MarcusQuek/Marcus-s-ESP32-Dev-Board/SM02B-SRSS-TB(LF)(SN).step

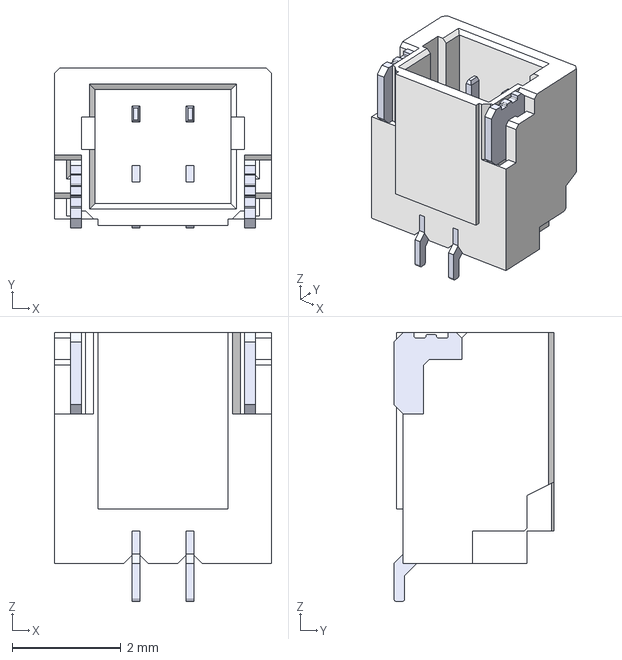
[picture p1: CAD file, 2025-12-24]
SM02B-SRSS-TB(LF)(SN).step
4.00 x 2.95 x 4.95 mm
