MarcusQuek/Marcus-s-ESP32-Dev-Board/MMC5983MA_MEM.step

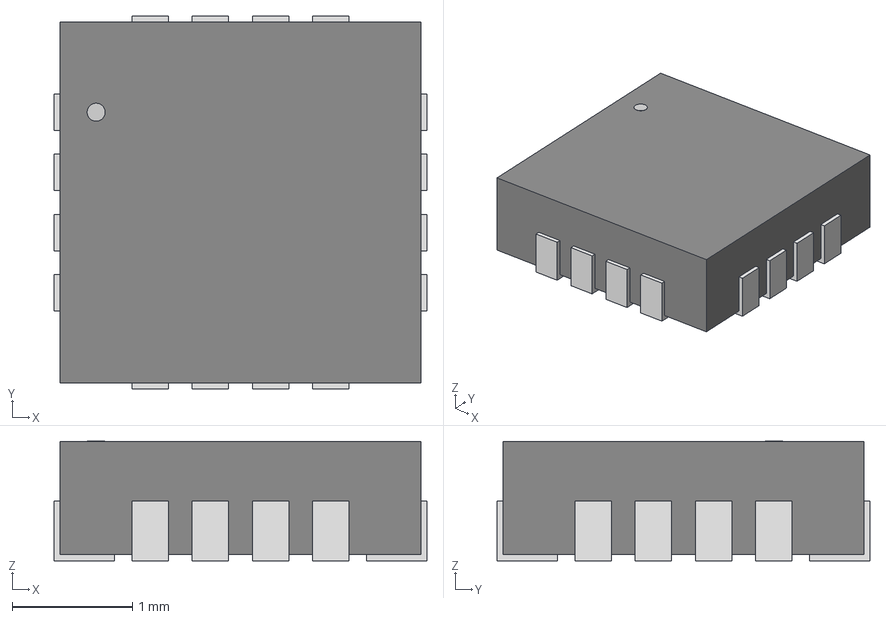
[picture p2: CAD file, 2025-12-24]
MMC5983MA_MEM.step
3.10 x 3.10 x 0.993 mm
