MarcusQuek/Marcus-s-ESP32-Dev-Board/ESP32-S3-WROOM-1U-N16R8.STEP

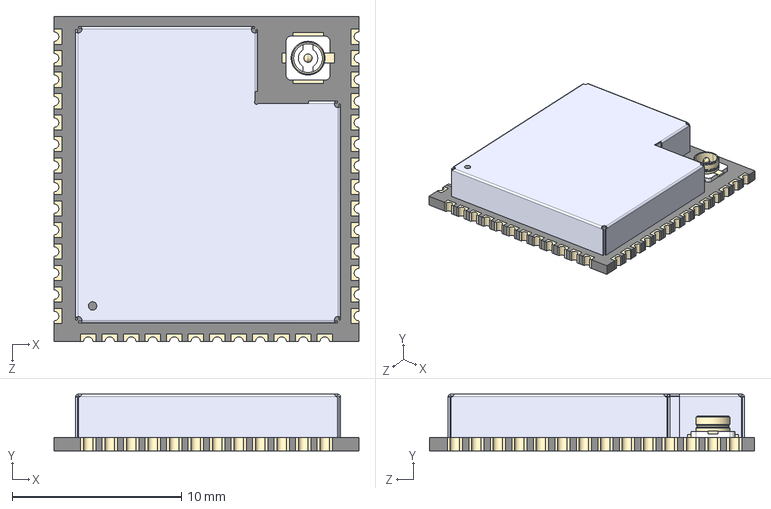
[picture p3: CAD file, 2025-12-22]
ESP32-S3-WROOM-1U-N16R8.STEP
18.0 x 3.35 x 19.2 mm
