MarcusQuek/Marcus-s-ESP32-Dev-Board/USB3076-30-A.STEP

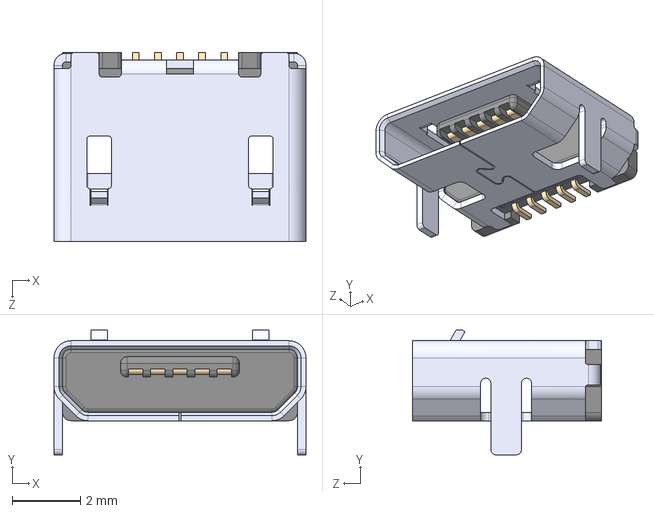
[picture p4: CAD file, 2025-12-22]
USB3076-30-A.STEP
7.40 x 3.66 x 5.55 mm
