MarcusQuek/Marcus-s-ESP32-Dev-Board/TPS63020DSJR.step

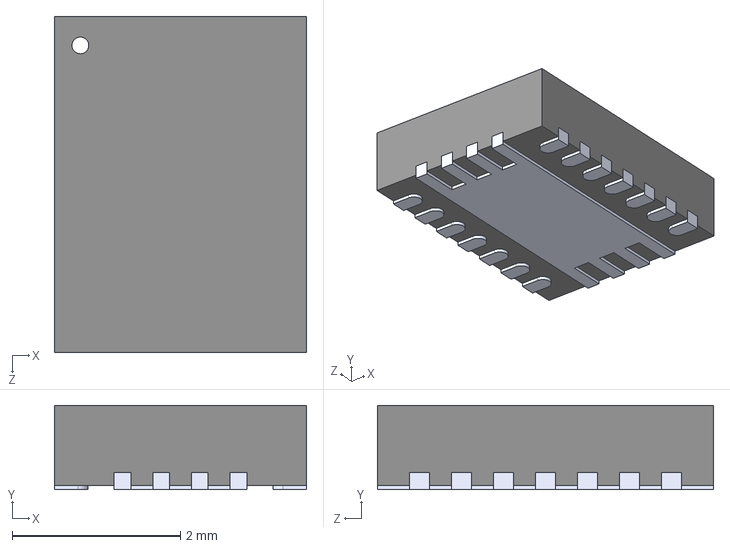
[picture p5: CAD file, 2025-12-24]
TPS63020DSJR.step
3.00 x 1.00 x 4.00 mm
