MarcusQuek/Marcus-s-ESP32-Dev-Board/MAX17048G_T10.step

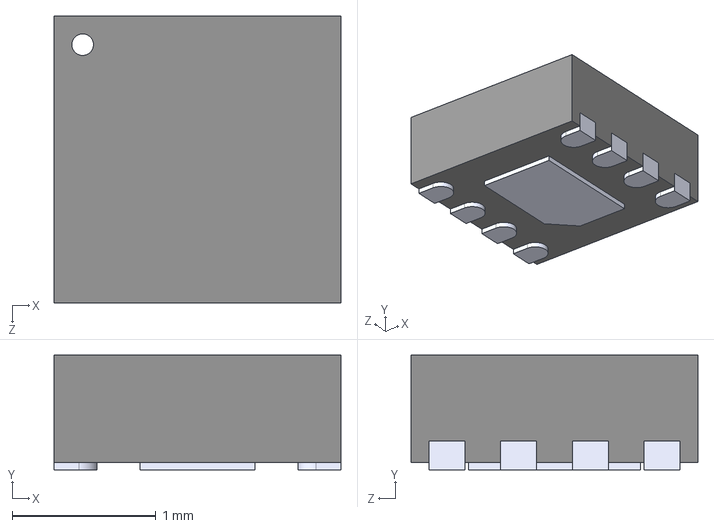
[picture p6: CAD file, 2025-12-24]
MAX17048G_T10.step
2.00 x 0.8 x 2.00 mm
