MarcusQuek/Marcus-s-ESP32-Dev-Board/0473092651.stp

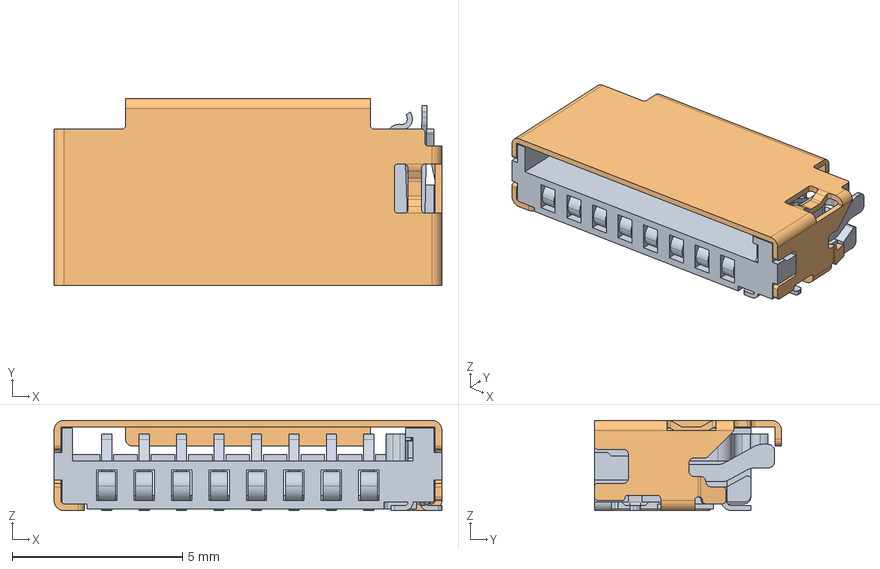
[picture p7: CAD file, 2025-12-24]
0473092651.stp
11.4 x 5.50 x 2.65 mm
