MarcusQuek/Marcus-s-ESP32-Dev-Board/Marcus's ESP32 Dev Board.kicad_pcb

## KiCad design Marcus's ESP32 Dev Board.kicad_pcb (2025-12-24)

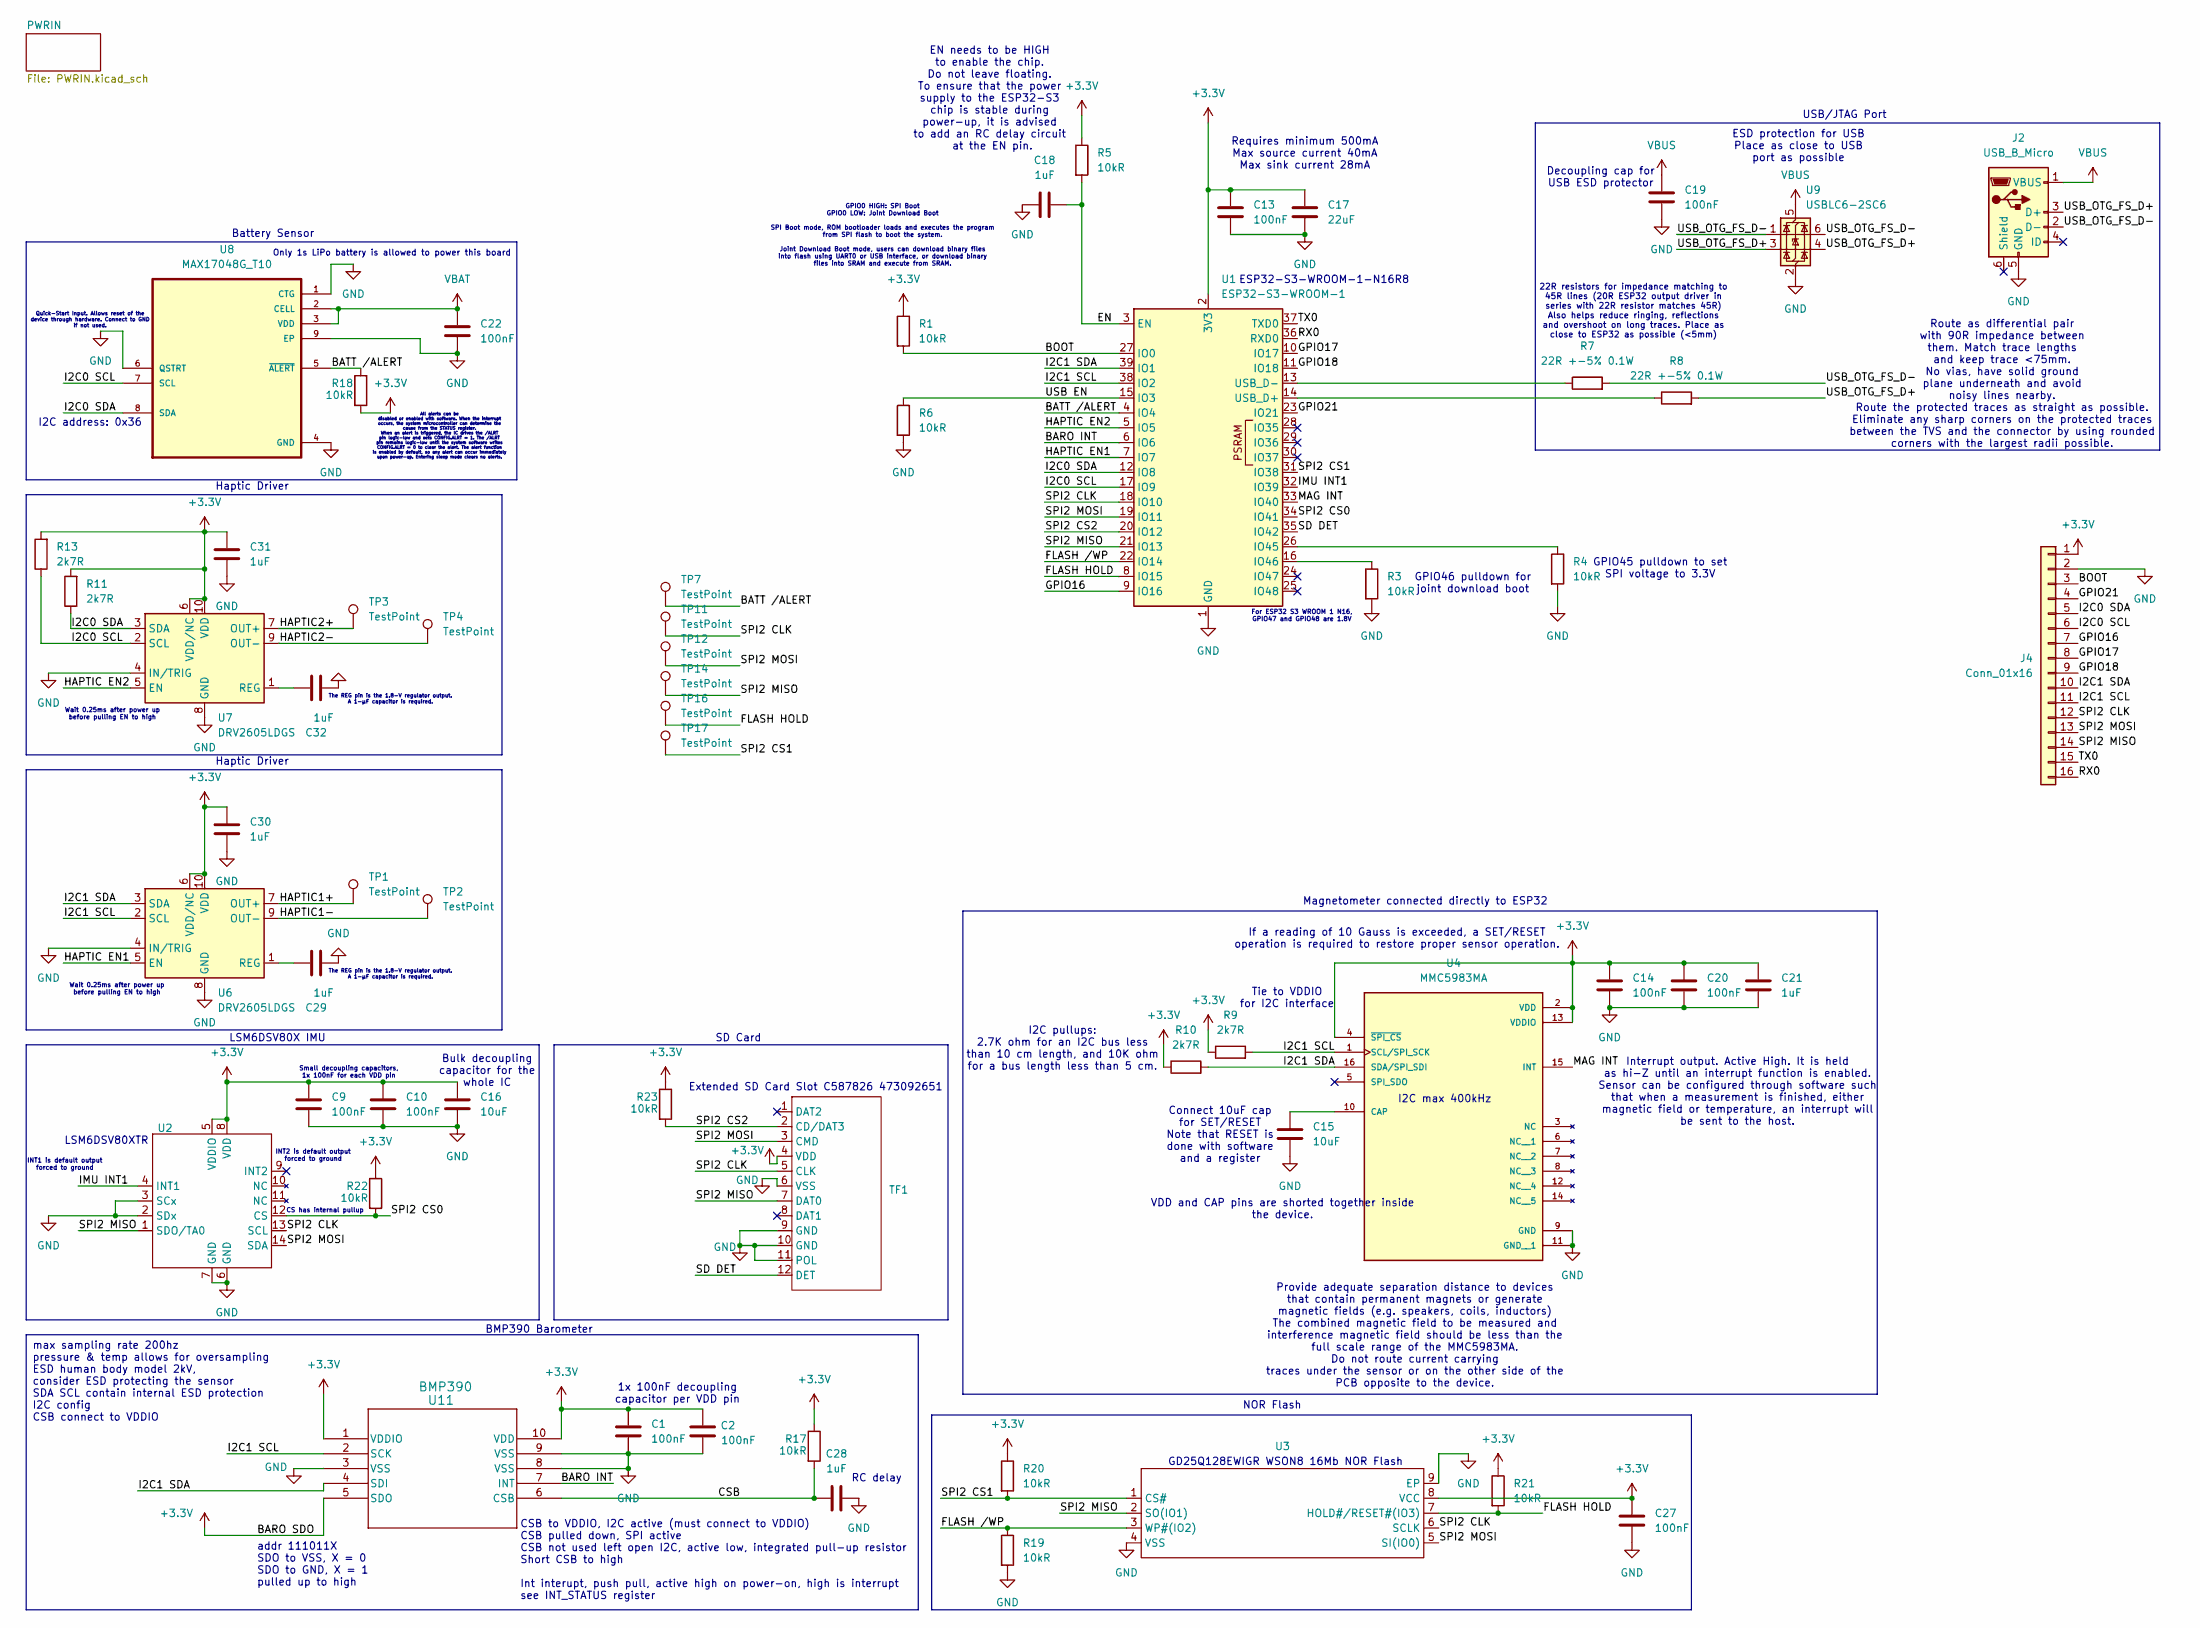
[picture p8: schematic Marcus's ESP32 Dev Board.kicad_sch]

Parts:
C1, C2, C9, C10, C13, C14, C19, C20, C22, C27: 100nF; C_0402_1005Metric
C15, C16: 10uF; C_0603_1608Metric
C17: 22uF; C_0805_2012Metric
C18, C21, C28, C29, C30, C31, C32: 1uF; C_0402_1005Metric
J2: USB_B_Micro; USB_Micro-B_GCT_USB3076-30-A
J4: Conn_01x16; PinHeader_1x16_P1.27mm_Vertical
R1, R3, R4, R5, R6, R17, R18, R19, R20, R21, R22, R23: 10kR; R_0201_0603Metric
R7, R8: 22R +-5% 0.1W; R_0201_0603Metric
R9, R10, R11, R13: 2k7R; C_0402_1005Metric
TF1: Extended SD Card Slot C587826 473092651; Manufacturer Part 473092651; LCSC Part Name 473092651
TP1, TP2, TP3, TP4: TestPoint; TestPoint_Pad_2.0x2.0mm
TP7, TP11, TP12, TP14, TP16, TP17: TestPoint; TestPoint_Pad_D1.0mm
U1: ESP32-S3-WROOM-1; ESP32-S3-WROOM-1U
U2: LGA-14_3x2.5mm_P0.5mm_LayoutBorder3x4y
U3: WSON-8-1EP_6x5mm_P1.27mm_EP3.4x4.3mm; Manufacturer Part GD25Q128EWIGR; LCSC Part Name 双路和四路串行闪存
U4: MMC5983MA; PARTREV A
U6, U7: DRV2605LDGS; VSSOP-10_3x3mm_P0.5mm
U8: MAX17048G_T10; MAX17048G+T10
U9: USBLC6-2SC6; SOT-23-6
U11: BMP390

Connections:
+3.3V: C1.1, C2.2, C9.1, C10.1, C13.1, C14.1, C16.1, C17.1, C20.1, C21.1, C27.1, C30.2, C31.2, J4.1, R1.1, R5.1, R9.1, R10.1, R11.2, R13.2, R17.1, R18.2, R20.1, R21.1, R22.1, R23.1, TF1.4 (VDD), U1.2 (3V3), U2.5 (VDDIO), U2.8 (VDD), U3.8 (VCC), U4.2 (VDD), U4.4 (~SPI_CS), U4.13 (VDDIO), U6.6 (VDD/NC), U6.10 (VDD), U7.6 (VDD/NC), U7.10 (VDD), U11.1 (VDDIO), U11.5 (SDO), U11.10 (VDD); also elsewhere on the board
/BARO INT: U1.6 (IO6), U11.7 (INT)
/BATT /ALERT: R18.1, TP7.1, U1.4 (IO4), U8.5 (~ALERT)
/BOOT: J4.3, R1.2, U1.27 (IO0)
/CSB: C28.1, R17.2, U11.6 (CSB)
/EN: C18.2, R5.2, U1.3 (EN)
/FLASH HOLD: R21.2, TP16.1, U1.8 (IO15), U3.7 (HOLD#/RESET#(IO3))
/FLASH /WP: R19.1, U1.22 (IO14), U3.3 (WP#(IO2))
/GPIO16: J4.7, U1.9 (IO16)
/GPIO17: J4.8, U1.10 (IO17)
/GPIO18: J4.9, U1.11 (IO18)
/GPIO21: J4.4, U1.23 (IO21)
/HAPTIC1+: TP1.1, U6.7 (OUT+)
/HAPTIC1-: TP2.1, U6.9 (OUT-)
/HAPTIC2+: TP3.1, U7.7 (OUT+)
/HAPTIC2-: TP4.1, U7.9 (OUT-)
/HAPTIC EN1: U1.7 (IO7), U6.5 (EN)
/HAPTIC EN2: U1.5 (IO5), U7.5 (EN)
/I2C0 SCL: J4.6, R13.1, U1.17 (IO9), U7.2 (SCL), U8.7 (SCL)
/I2C0 SDA: J4.5, R11.1, U1.12 (IO8), U7.3 (SDA), U8.8 (SDA)
/I2C1 SCL: J4.11, R9.2, U1.38 (IO2), U4.1 (SCL/SPI_SCK), U6.2 (SCL), U11.2 (SCK)
/I2C1 SDA: J4.10, R10.2, U1.39 (IO1), U4.16 (SDA/SPI_SDI), U6.3 (SDA), U11.4 (SDI)
/IMU INT1: U1.32 (IO39), U2.4 (INT1)
/MAG INT: U1.33 (IO40), U4.15 (INT)
/RX0: J4.16, U1.36 (RXD0)
/SD DET: TF1.12 (DET), U1.35 (IO42)
/SPI2 CLK: J4.12, TF1.5 (CLK), TP11.1, U1.18 (IO10), U2.13 (SCL), U3.6 (SCLK)
/SPI2 CS0: R22.2, U1.34 (IO41), U2.12 (CS)
/SPI2 CS1: R20.2, TP17.1, U1.31 (IO38), U3.1 (CS#)
/SPI2 CS2: R23.2, TF1.2 (CD/DAT3), U1.20 (IO12)
/SPI2 MISO: J4.14, TF1.7 (DAT0), TP14.1, U1.21 (IO13), U2.1 (SDO/TA0), U3.2 (SO(IO1))
/SPI2 MOSI: J4.13, TF1.3 (CMD), TP12.1, U1.19 (IO11), U2.14 (SDA), U3.5 (SI(IO0))
/TX0: J4.15, U1.37 (TXD0)
/USB EN: R6.1, U1.15 (IO3)
/USB_OTG_FS_D+: J2.3 (D+), R8.2, U9.3 (I/O2), U9.4 (I/O2)
/USB_OTG_FS_D-: J2.2 (D-), R7.2, U9.1 (I/O1), U9.6 (I/O1)
GND: C1.2, C2.1, C9.2, C10.2, C13.2, C14.2, C15.2, C16.2, C17.2, C18.1, C19.2, C20.2, C21.2, C22.2, C27.2, C28.2, C29.1, C30.1, C31.1, C32.1, J2.5 (GND), J4.2, R3.2, R4.2, R6.2, R19.2, TF1.6 (VSS), TF1.9 (GND), TF1.10 (GND), TF1.11 (POL), U1.1 (GND), U1.40 (GND), U1.41 (GND), U2.2 (SDx), U2.3 (SCx), U2.6 (GND), U2.7 (GND), U3.4 (VSS), U3.9 (EP), U4.9 (GND), U4.11 (GND__1), U6.4 (IN/TRIG), U6.8 (GND), U7.4 (IN/TRIG), U7.8 (GND), U8.1 (CTG), U8.4 (GND), U8.6 (QSTRT), U8.9 (EP), U9.2 (GND), U11.3 (VSS), U11.8 (VSS), U11.9 (VSS); also elsewhere on the board
unnamed: R4.1, U1.26 (IO45)
unnamed: R3.1, U1.16 (IO46)
unnamed: R8.1, U1.14 (USB_D+)
unnamed: R7.1, U1.13 (USB_D-)
unnamed: C15.1, U4.10 (CAP)
unnamed: C29.2, U6.1 (REG)
unnamed: C32.2, U7.1 (REG)
VBAT: C22.1, U8.2 (CELL), U8.3 (VDD); also elsewhere on the board
VBUS: C19.1, J2.1 (VBUS), U9.5 (VBUS); also elsewhere on the board

Notes on the sheet:
LSM6DSV80XTR
INT2 is default output forced to ground
I2C address: 0x36
Connect 10uF cap for SET/RESET Note that RESET is done with software and a register
EN needs to be HIGH to enable the chip. Do not leave floating. To ensure that the power supply to the ESP32-S3 chip is stable during power-up, it is advised to add an RC delay circuit at the EN pin.
ESP32-S3-WROOM-1-N16R8
ESD protection for USB Place as close to USB port as possible
CS has internal pullup
GPIO46 pulldown for joint download boot
VDD and CAP pins are shorted together inside the device.
Battery Sensor
GPIO45 pulldown to set SPI voltage to 3.3V
Route as differential pair with 90R impedance between them. Match trace lengths and keep trace <75mm. No vias, have solid ground plane underneath and avoid noisy lines nearby. Route the protected traces as straight as possible. Eliminate any sharp corners on the protected traces between the TVS and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
Wait 0.25ms after power up before pulling EN to high
Small decoupling capacitors, 1x 100nF for each VDD pin
I2C max 400kHz
LSM6DSV80X IMU
RC delay
Extended SD Card Slot C587826 473092651
Bulk decoupling capacitor for the whole IC
Haptic Driver
addr 111011X SDO to VSS, X = 0 SDO to GND, X = 1 pulled up to high
max sampling rate 200hz pressure & temp allows for oversampling ESD human body model 2kV, consider ESD protecting the sensor SDA SCL contain internal ESD protection I2C config CSB connect to VDDIO
Only 1s LiPo battery is allowed to power this board
For ESP32 S3 WROOM 1 N16, GPIO47 and GPIO48 are 1.8V
Magnetometer connected directly to ESP32
I2C pullups: 2.7K ohm for an I2C bus less than 10 cm length, and 10K ohm for a bus length less than 5 cm.
Tie to VDDIO for I2C interface
The REG pin is the 1.8-V regulator output. A 1-µF capacitor is required.
Interrupt output. Active High. It is held as hi-Z until an interrupt function is enabled. Sensor can be configured through software such that when a measurement is finished, either magnetic field or temperature, an interrupt will be sent to the host.
Requires minimum 500mA Max source current 40mA Max sink current 28mA
INT1 is default output forced to ground
BMP390 Barometer
1x 100nF decoupling capacitor per VDD pin
Quick-Start Input. Allows reset of the device through hardware. Connect to GND if not used.
NOR Flash
USB/JTAG Port
All alerts can be disabled or enabled with software. When the interrupt occurs, the system microcontroller can determine the cause from the STATUS register. When an alert is triggered, the IC drives the /ALRT pin logic-low and sets CONFIG.ALRT = 1. The /ALRT pin remains logic-low until the system s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
CSB to VDDIO, I2C active (must connect to VDDIO) CSB pulled down, SPI active CSB not used left open I2C, active low, integrated pull-up resistor Short CSB to high Int interupt, push pull, active high on power-on, high is interrupt see INT_STATUS register
22R resistors for impedance matching to 45R lines (20R ESP32 output driver in series with 22R resistor matches 45R) Also helps reduce ringing, reflections and overshoot on long traces. Place as close to ESP32 as possible (<5mm)
GPIO0 HIGH: SPI Boot GPIO0 LOW: Joint Download Boot SPI Boot mode, ROM bootloader loads and executes the program from SPI flash to boot the system. Joint Download Boot mode, users can download binary files into flash using UART0 or USB interface, or download binary files into SRAM and execute from 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
GD25Q128EWIGR WSON8 16Mb NOR Flash
SD Card
Provide adequate separation distance to devices that contain permanent magnets or generate magnetic fields (e.g. speakers, coils, inductors) The combined magnetic field to be measured and interference magnetic field should be less than the full scale range of the MMC5983MA. Do not route current car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
Decoupling cap for USB ESD protector
If a reading of 10 Gauss is exceeded, a SET/RESET operation is required to restore proper sensor operation.

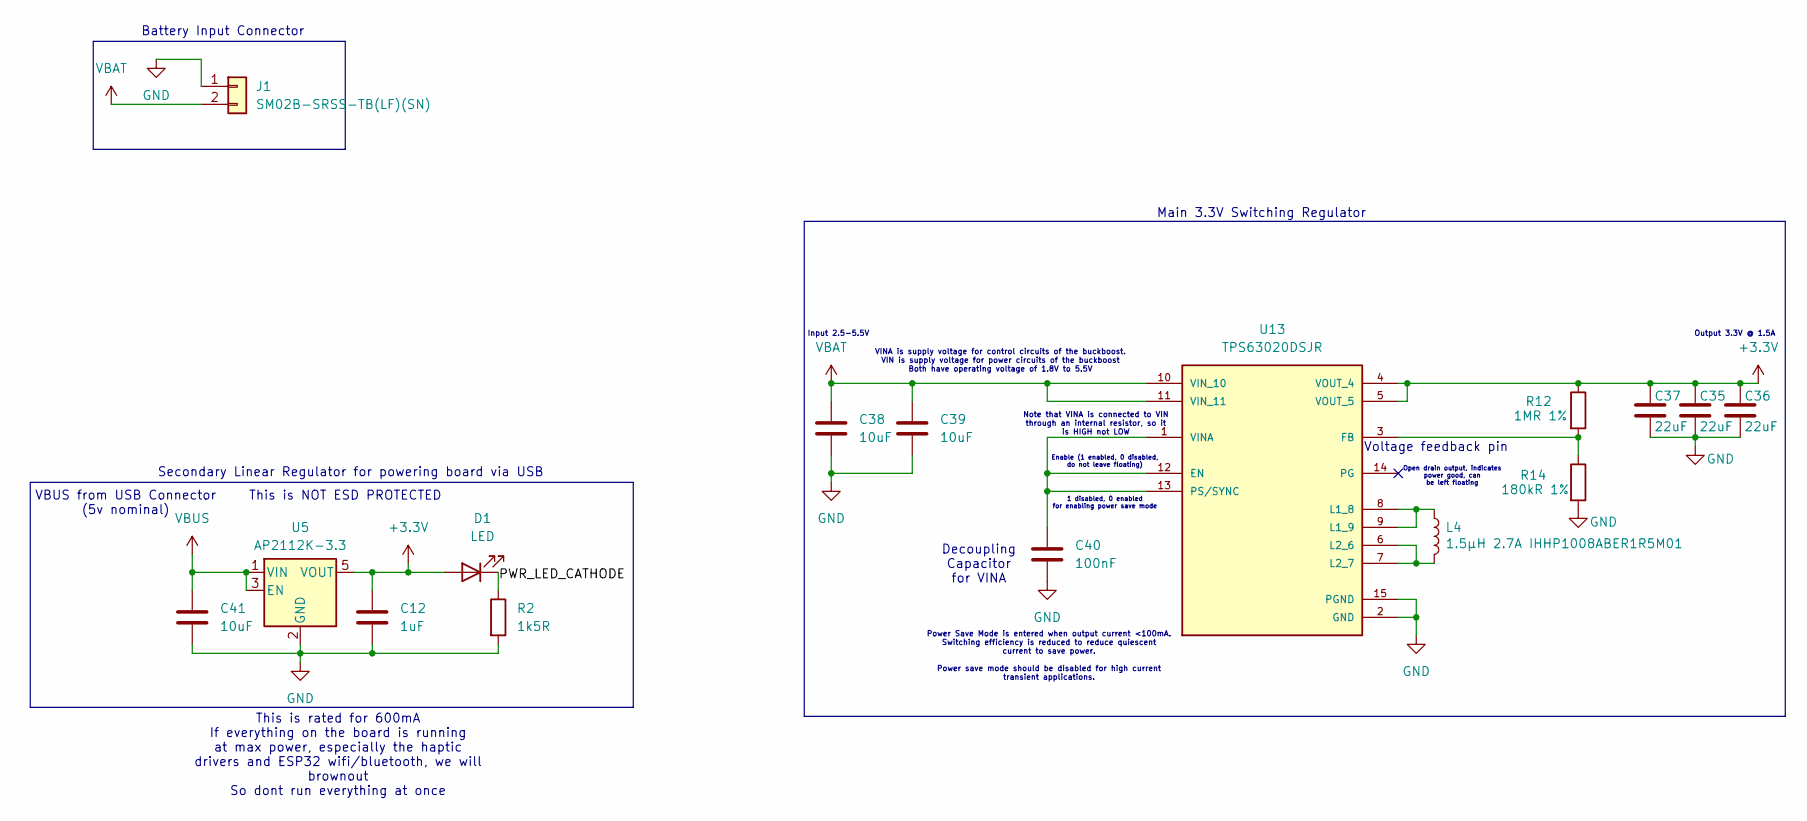
[picture p9: schematic PWRIN.kicad_sch]

Parts:
C12: 1uF; C_0402_1005Metric
C35, C36, C37: 22uF; C_0805_2012Metric
C38, C39, C41: 10uF; C_0603_1608Metric
C40: 100nF; C_0402_1005Metric
D1: LED; LED_0603_1608Metric
J1: SM02B-SRSS-TB(LF)(SN); JST_SH_SM02B-SRSS-TB_1x02-1MP_P1.00mm_Horizontal
L4: 1.5µH 2.7A IHHP1008ABER1R5M01; L_1008_2520Metric
R2: 1k5R; C_0402_1005Metric
R12: 1MR 1%; R_0201_0603Metric
R14: 180kR 1%; R_0201_0603Metric
U5: AP2112K-3.3; SOT-23-5
U13: TPS63020DSJR

Connections:
+3.3V: C12.1, C35.1, C36.1, C37.1, D1.2 (A), R12.1, U5.5 (VOUT), U13.4 (VOUT_4), U13.5 (VOUT_5); also elsewhere on the board
/PWRIN/PWR_LED_CATHODE: D1.1 (K), R2.1
GND: C12.2, C35.2, C36.2, C37.2, C38.2, C39.2, C40.2, C41.2, J1.1, R2.2, R14.2, U5.2 (GND), U13.2 (GND), U13.15 (PGND), U13.16, U13.18, U13.20, U13.22, U13.24, U13.26, U13.28, U13.30; also elsewhere on the board
unnamed: C40.1, U13.1 (VINA), U13.12 (EN), U13.13 (PS/SYNC)
unnamed: R12.2, R14.1, U13.3 (FB)
unnamed: L4.1, U13.8 (L1_8), U13.9 (L1_9)
unnamed: L4.2, U13.6 (L2_6), U13.7 (L2_7)
VBAT: C38.1, C39.1, J1.2, U13.10 (VIN_10), U13.11 (VIN_11); also elsewhere on the board
VBUS: C41.1, U5.1 (VIN), U5.3 (EN); also elsewhere on the board

Notes on the sheet:
Power Save Mode is entered when output current <100mA. Switching efficiency is reduced to reduce quiescent current to save power. Power save mode should be disabled for high current transient applications.
Note that VINA is connected to VIN through an internal resistor, so it is HIGH not LOW
This is NOT ESD PROTECTED
Voltage feedback pin
Secondary Linear Regulator for powering board via USB
Battery Input Connector
VINA is supply voltage for control circuits of the buckboost. VIN is supply voltage for power circuits of the buckboost Both have operating voltage of 1.8V to 5.5V
Decoupling Capacitor for VINA
1 disabled, 0 enabled for enabling power save mode
Enable (1 enabled, 0 disabled, do not leave floating)
Output 3.3V @ 1.5A
VBUS from USB Connector (5v nominal)
Open drain output, indicates power good, can be left floating
Input 2.5-5.5V
Main 3.3V Switching Regulator
This is rated for 600mA If everything on the board is running at max power, especially the haptic drivers and ESP32 wifi/bluetooth, we will brownout So dont run everything at once

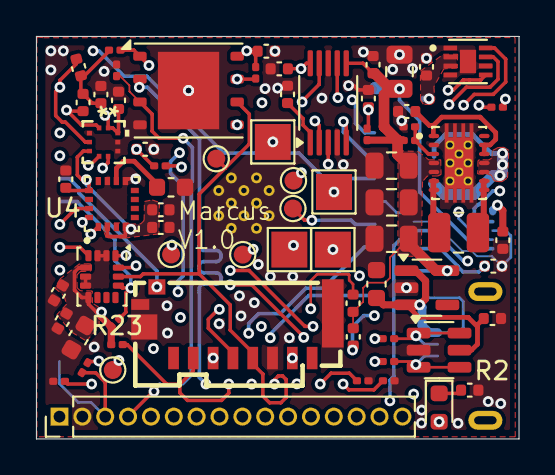
[picture p10: board Marcus's ESP32 Dev Board.kicad_pcb from above]

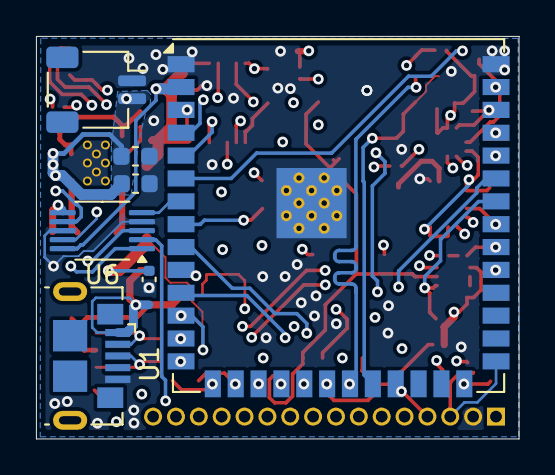
[picture p11: board Marcus's ESP32 Dev Board.kicad_pcb from below]

Board: 6 copper layers, 26.8 x 22.4 mm, 76 parts (7 on the bottom side), 51 nets.
