MarcusQuek/Marcus-s-ESP32-Dev-Board/(commit log)

2025-12-22 feat(pcb) split haptic drivers into different i2c buses
    [ESP32-S3-WROOM-1U-N16R8.STEP, Marcus's ESP32 Dev Board.kicad_pcb, Marcus's ESP32 Dev Board.kicad_sch, PWRIN.kicad_sch, USB3076-30-A.STEP]
2025-12-22 feat(pcb) length match battery sensor i2c
    [Marcus's ESP32 Dev Board.kicad_pcb]
2025-12-22 feat(pcb) add pullups to I2C0, move battery sensor to I2C0
    [Marcus's ESP32 Dev Board.kicad_pcb, Marcus's ESP32 Dev Board.kicad_sch]
2025-12-24 feat(pcb) cleanup and improve reliability
    add pullups to SPI CS lines, rearrange board slightly, add V1.0 silkscreen, increase size of VBUS input cap
    [Marcus's ESP32 Dev Board.kicad_pcb, Marcus's ESP32 Dev Board.kicad_sch, PWRIN.kicad_sch]
2025-12-24 feat(cad) add 3d models
    [0473092651.stp, MAX17048G_T10.step, MMC5983MA_MEM.step, Marcus's ESP32 Dev Board.kicad_pcb, SM02B-SRSS-TB(LF)(SN).step, TPS63020DSJR.step]
